PaulBadeuille/ArduinoClock/ArduinoClock (4).jpg

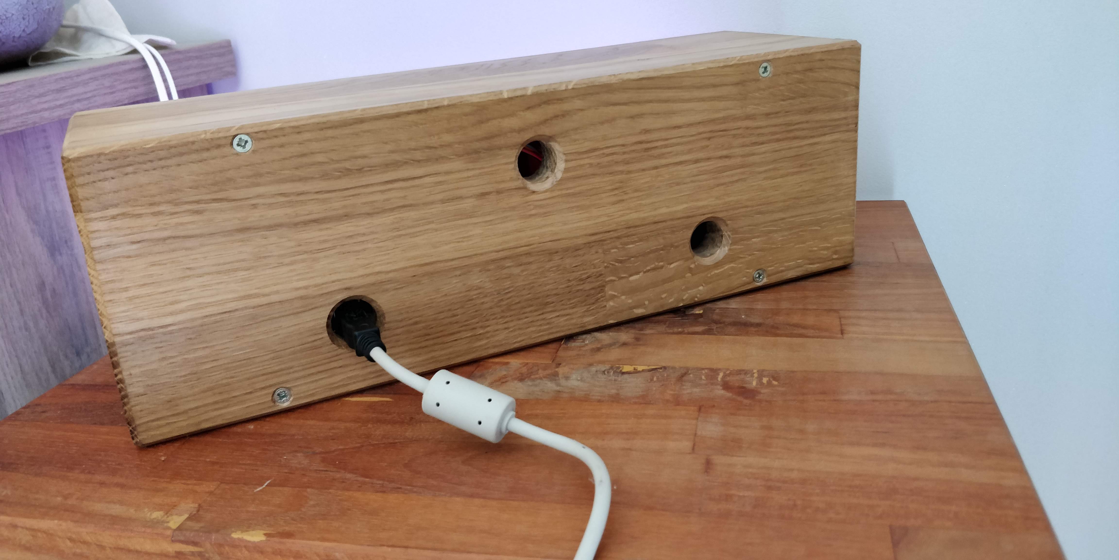
ArduinoClock (4).jpg
