PaulBadeuille/ArduinoClock/ArduinoClock (2).jpg

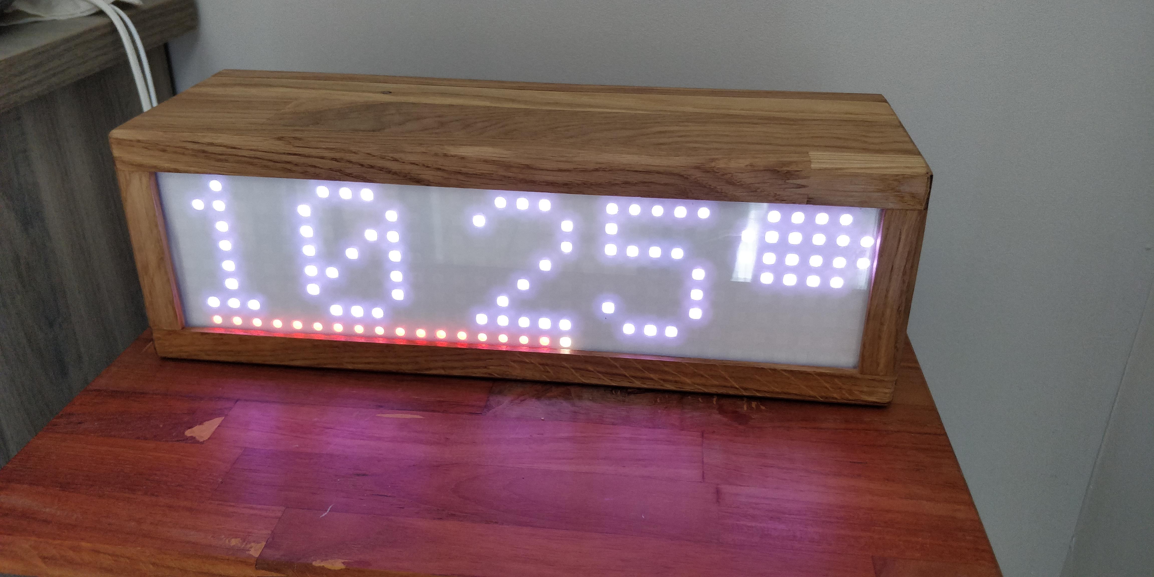
ArduinoClock (2).jpg
