PaulBadeuille/ArduinoClock/ArduinoClock (1).jpg

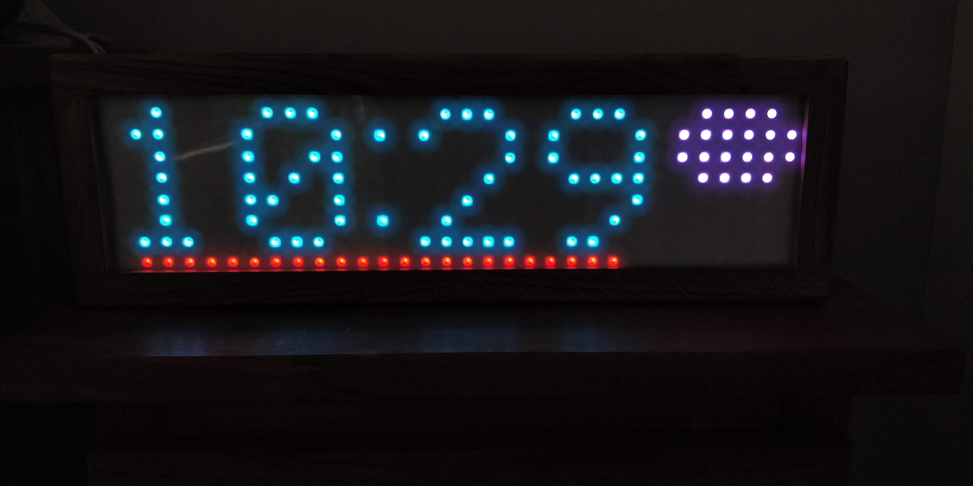
ArduinoClock (1).jpg
