PaulBadeuille/ArduinoClock/ArduinoClock (3).jpg

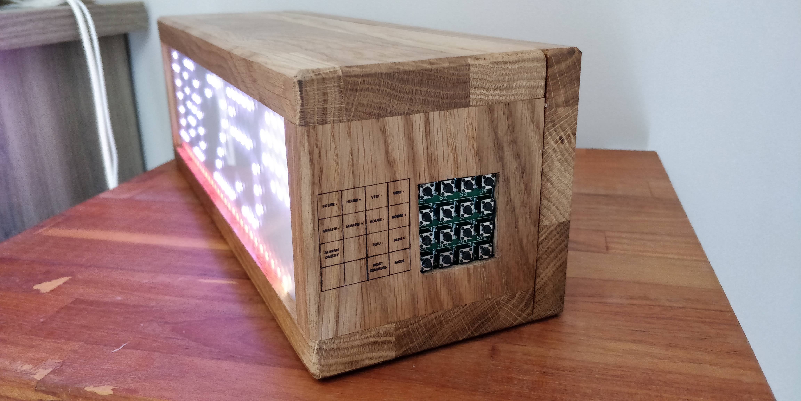
ArduinoClock (3).jpg
