PaulBadeuille/ArduinoClock/ArduinoClock (5).jpg

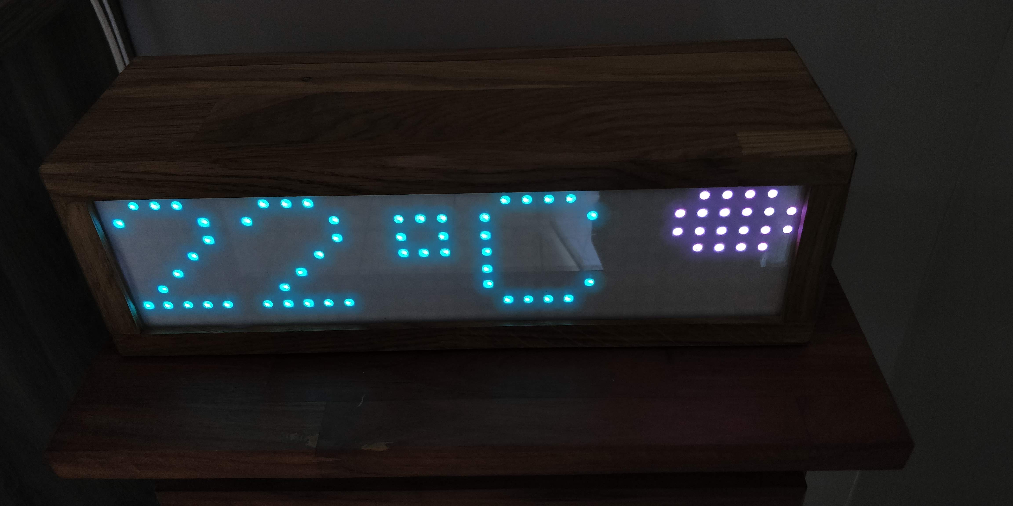
ArduinoClock (5).jpg
