PaulBadeuille/ArduinoClock/ArduinoClock (6).jpg

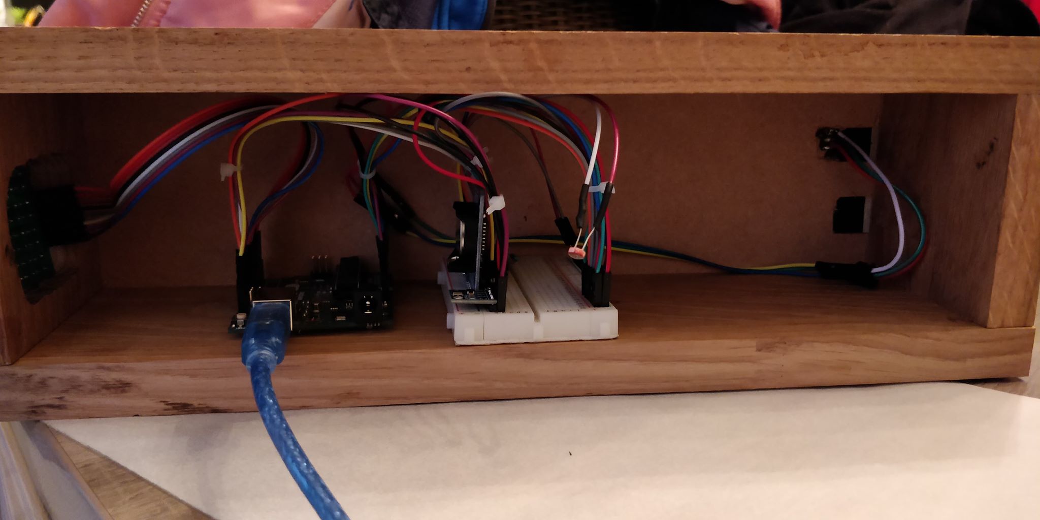
ArduinoClock (6).jpg
