PaulBadeuille/ArduinoClock/buttons.png

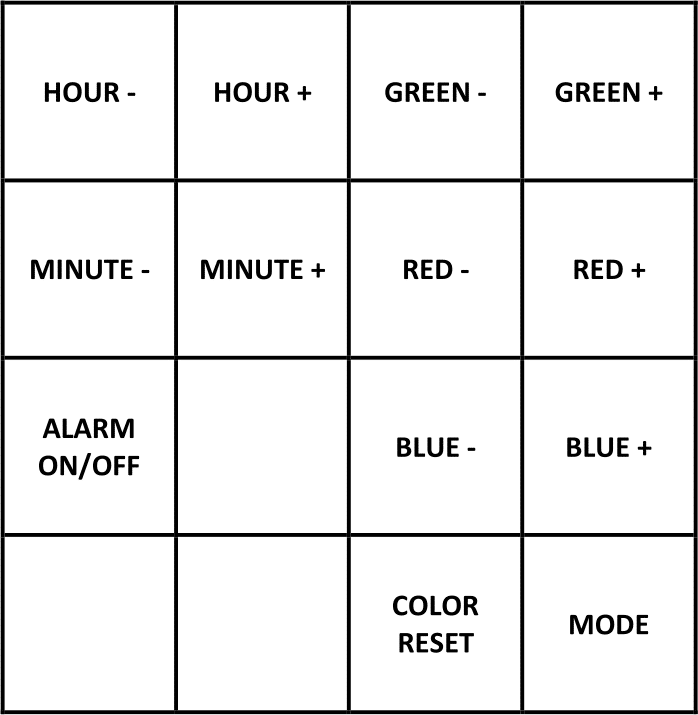
buttons.png
