PaulBadeuille/ArduinoClock/gerer_matrice.h

void modifierMatrice(int chiffre, int pos, int afficheur[256])
{
  int couleur[35];
  for (int i = 0; i < 35; i++)
  {
    couleur[i] = 0;
  }
  switch (chiffre)
  {
    case 1:
      couleur[2] = 1;
      couleur[6] = 1;
      couleur[7] = 1;
      couleur[12] = 1;
      couleur[17] = 1;
      couleur[22] = 1;
      couleur[27] = 1;
      couleur[31] = 1;
      couleur[32] = 1;
      couleur[33] = 1;
      break;
    case 2:
      couleur[1] = 1;
      couleur[2] = 1;
      couleur[3] = 1;
      couleur[5] = 1;
      couleur[9] = 1;
      couleur[14] = 1;
      couleur[18] = 1;
      couleur[22] = 1;
      couleur[26] = 1;
      couleur[30] = 1;
      couleur[31] = 1;
      couleur[32] = 1;
      couleur[33] = 1;
      couleur[34] = 1;
      break;
    case 3:
      couleur[0] = 1;
      couleur[1] = 1;
      couleur[2] = 1;
      couleur[3] = 1;
      couleur[4] = 1;
      couleur[8] = 1;
      couleur[12] = 1;
      couleur[18] = 1;
      couleur[24] = 1;
      couleur[25] = 1;
      couleur[29] = 1;
      couleur[31] = 1;
      couleur[32] = 1;
      couleur[33] = 1;
      break;
    case 4:
      couleur[3] = 1;
      couleur[7] = 1;
      couleur[8] = 1;
      couleur[11] = 1;
      couleur[13] = 1;
      couleur[15] = 1;
      couleur[18] = 1;
      couleur[20] = 1;
      couleur[21] = 1;
      couleur[22] = 1;
      couleur[23] = 1;
      couleur[24] = 1;
      couleur[28] = 1;
      couleur[33] = 1;
      break;
    case 5:
      couleur[0] = 1;
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
    leds[92].green = (r + g + b) / 3;
    leds[92].blue = (r + g + b) / 3;
    leds[93].red = (r + g + b) / 3;
    leds[93].green = (r + g + b) / 3;
    leds[93].blue = (r + g + b) / 3;
    leds[94].red = (r + g + b) / 3;
    leds[94].green = (r + g + b) / 3;
    leds[94].blue = (r + g + b) / 3;
    leds[95].red = (r + g + b) / 3;
    leds[95].green = (r + g + b) / 3;
    leds[95].blue = (r + g + b) / 3;
    leds[100].red = (r + g + b) / 3;
    leds[100].green = (r + g + b) / 3;
    leds[100].blue = (r + g + b) / 3;
    leds[99].red = (r + g + b) / 3;
    leds[99].green = (r + g + b) / 3;
    leds[99].blue = (r + g + b) / 3;
    leds[98].red = (r + g + b) / 3;
    leds[98].green = (r + g + b) / 3;
    leds[98].blue = (r + g + b) / 3;
    leds[97].red = (r + g + b) / 3;
    leds[97].green = (r + g + b) / 3;
    leds[97].blue = (r + g + b) / 3;
  }
  FastLED.show();
}
